niccolascassel/altosdofloresta/README.md

altosdofloresta
===============

Altos do Floresta allotment's projects
