niccolascassel/altosdofloresta/Documentation/Flowcharts/PlumbingPressureControl.pdf

# CONTROLE DE PRESSÃO DO SISTEMA

Controla o acionamento das bombas de acordo com a pressão do sistema. Esta função é chamada pela função Main.

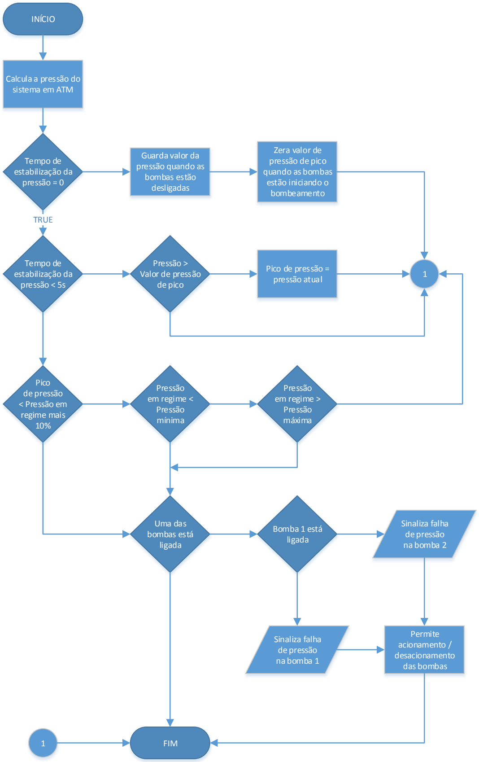
[picture p1: figure]
INÍCIO; Calcula a pressão do sistema em ATM; Tempo de estabilização da pressão = 0; Tempo de estabilização da pressão < 5s; TRUE; Guarda valor da pressão quando as bombas estão desligadas; Zera valor de pressão de pico quando as bombas estão iniciando o bombeamento; Pressão > Valor de pressão de pico; Pico de pressão = pressão atual; Pico de pressão < Pressão em regime mais 10%; Pressão em regime < Pressão mínima; Pressão em regime > Pressão máxima; Uma das bombas está ligada; Bomba 1 está ligada; Sinaliza falha de pressão na bomba 2; Sinaliza falha de pressão na bomba 1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
