niccolascassel/altosdofloresta/Documentation/Flowcharts/Signals.pdf

# Sinalizações

Aciona os LEDs de sinalização de acordo com as falhas que ocorrerem. Esta função é chamada pela função Main.

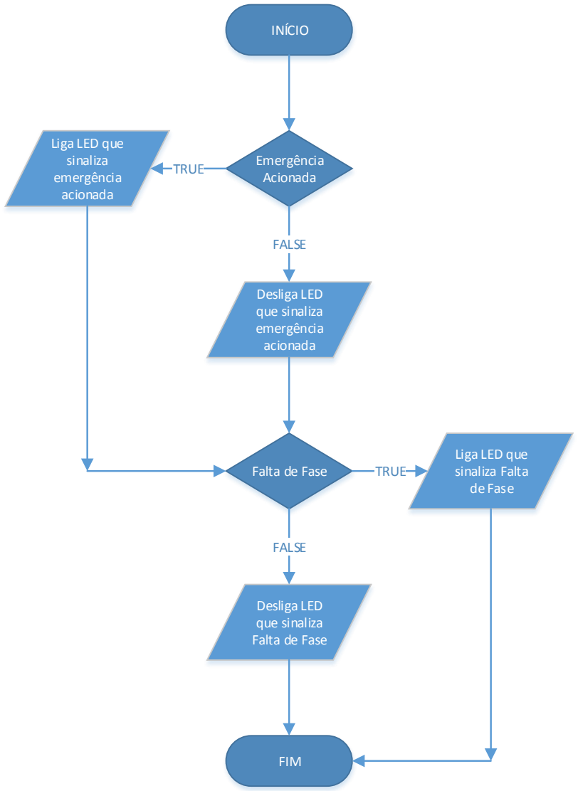
[picture p2: figure]
INÍCIO; Emergência Acionada; Liga LED que sinaliza emergência acionada; Desliga LED que sinaliza emergência acionada; Falta de Fase; Liga LED que sinaliza Falta de Fase; Desliga LED que sinaliza Falta de Fase; FIM; TRUE; FALSE
