niccolascassel/altosdofloresta/Documentation/ART-AltoFloresta.pdf

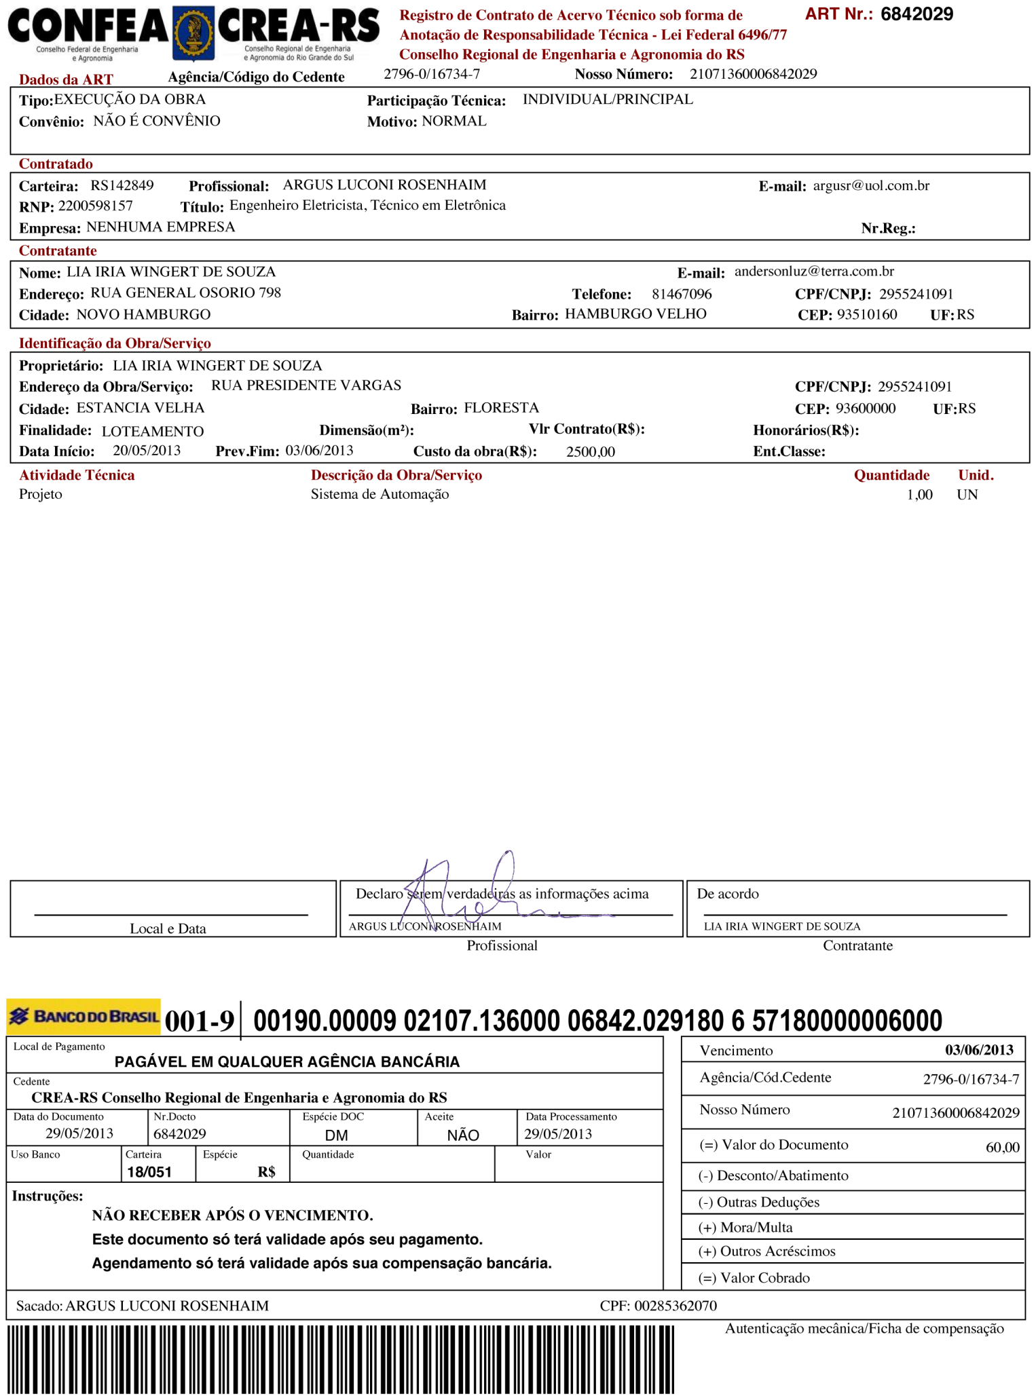
[picture p5: page 1]
