niccolascassel/altosdofloresta/Documentation/Flowcharts/Main.pdf

# MAIN

Esta função é chamada pela função de controle das bases de tempo.

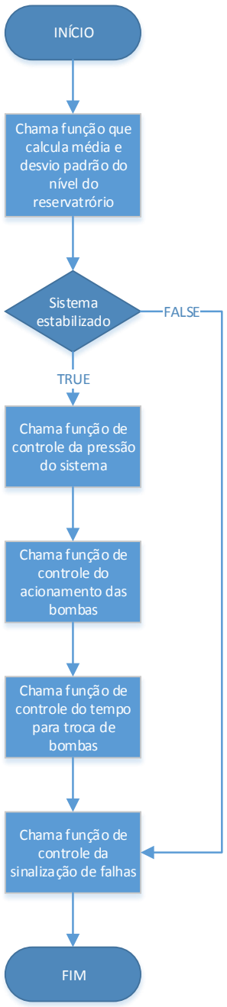
[picture p6: figure]
INÍCIO; Chama função que calcula média e desvio padrão do nível do reservatrório; Sistema estabilizado; Chama função de controle da pressão do sistema; Chama função de controle do acionamento das bombas; Chama função de controle do tempo para troca de bombas; Chama função de controle da sinalização de falhas; FIM; TRUE; FALSE
