niccolascassel/altosdofloresta/Documentation/Flowcharts/ReservoirLevelControl.pdf

# CONTROLE DO NÍVEL DO RESERVATÓRIO

Controla o acionamento das bombas de acordo com o nível do reservatório. Esta função é chamada pela função que calcula a média e o desvio padrão do nível do reservatório.

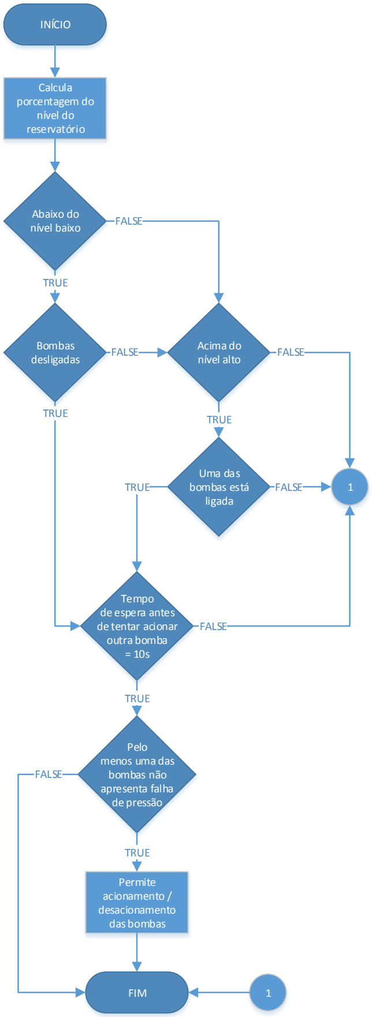
[picture p7: figure]
INÍCIO; Calcula porcentagem do nível do reservatório; Abaixo do nível baixo; Bombas desligadas; Acima do nível alto; Uma das bombas está ligada; Tempo de espera antes de tentar acionar outra bomba = 10s; Pelo menos uma das bombas não apresenta falha de pressão; Permite acionamento / desacionamento das bombas; FIM; FALSE; TRUE; TRUE TRUE
