niccolascassel/altosdofloresta/Documentation/Flowcharts/TimeDrivenPumpControl.pdf

# CONTROLE DE TEMPO DE BOMBA LIGADA

Controla o tempo que as bombas estão trabalhando para que trabalhem apenas 500 horas por vez.

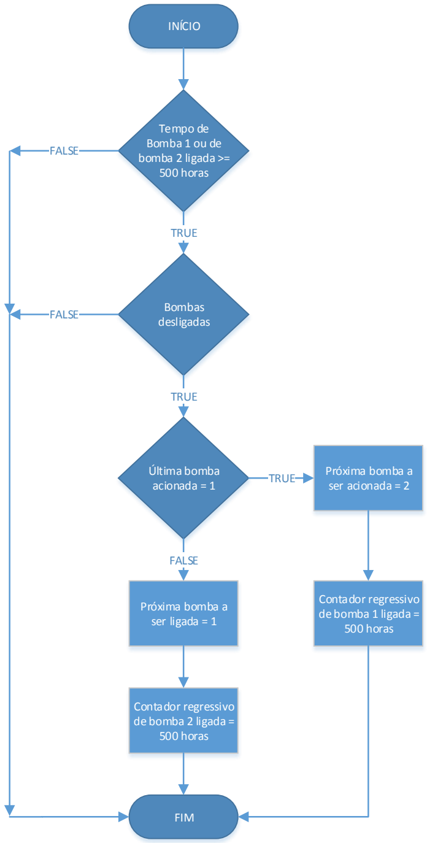
[picture p8: figure]
INÍCIO; Tempo de Bomba 1 ou de bomba 2 ligada >= 500 horas; Bombas desligadas; Última bomba acionada = 1; Próxima bomba a ser acionada = 2; Contador regressivo de bomba 1 ligada = 500 horas; Próxima bomba a ser ligada = 1; Contador regressivo de bomba 2 ligada = 500 horas; FIM; TRUE; FALSE
