niccolascassel/altosdofloresta/(list of files, cad)

Other CAD files:
Drawings/07 - SPDA Reservatório Superior.dwg
Drawings/06 - Instalação Sensor Nível e Quadro Reservatório.dwg
Drawings/05 - Layout QGBT e Quadro de Instrumentação.dwg
Drawings/03 - Esquema Elétrico do QGBT.dwg
Drawings/04 - Esquema Elétrico Instrumentação e Listas.dwg
Drawings/01 - Situação, Entrada e Aterramento.dwg
Drawings/02 - Casa de Bombas & Quadro de Cargas.dwg
Drawings/Calhas e Trilhos.dwg
Drawings/CAIXA_PASSAGEM_SAIDA.dwg
