niccolascassel/altosdofloresta/Documentation/Flowcharts/CommunicationChecks.pdf

# CHECAGEM DOS LINKS DE COMUNICAÇÃO

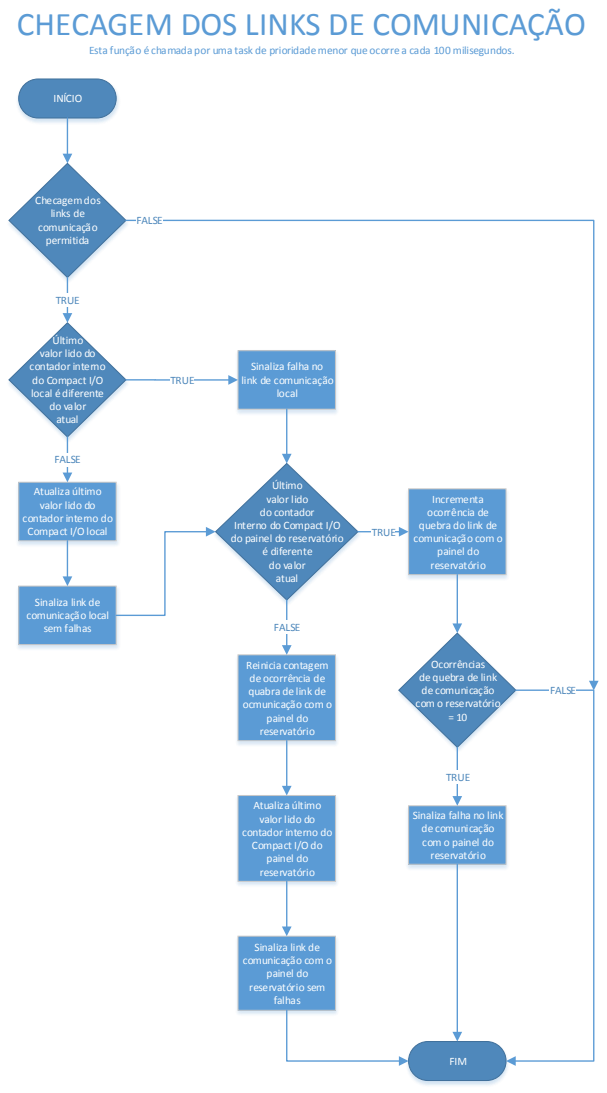
[picture p9: page 1]
INÍCIO; local; FIM; Checagem dos links de comunicação permitida; TRUE; FALSE

Esta função é chamada por uma task de prioridade menor que ocorre a cada 100 milisegundos.

Último
valor lido do
contador interno
do Compact I/O
local é diferente
do valor
atual

Sinaliza falha no
link de comunicação

valor lido
do contador
Interno do Compact I/O
do painel do reservatório
é diferente

Atualiza último
contador interno do
Compact I/O local

Incrementa
ocorrência de
quebra do link de
comunicação com o
painel do
reservatório

Sinaliza link de
comunicação local
sem falhas

Ocorrências
de quebra de link
de comunicação
com o reservatório

Reinicia contagem
de ocorrência de
quabra de link de
ocmunicação com o

Compact I/O do

Sinaliza falha no link
com o painel do

reservatório sem
falhas
