niccolascassel/altosdofloresta/Documentation/Flowcharts/DrivePumpControl.pdf

# CONTROLE DE ACIONAMENTO DAS BOMBAS

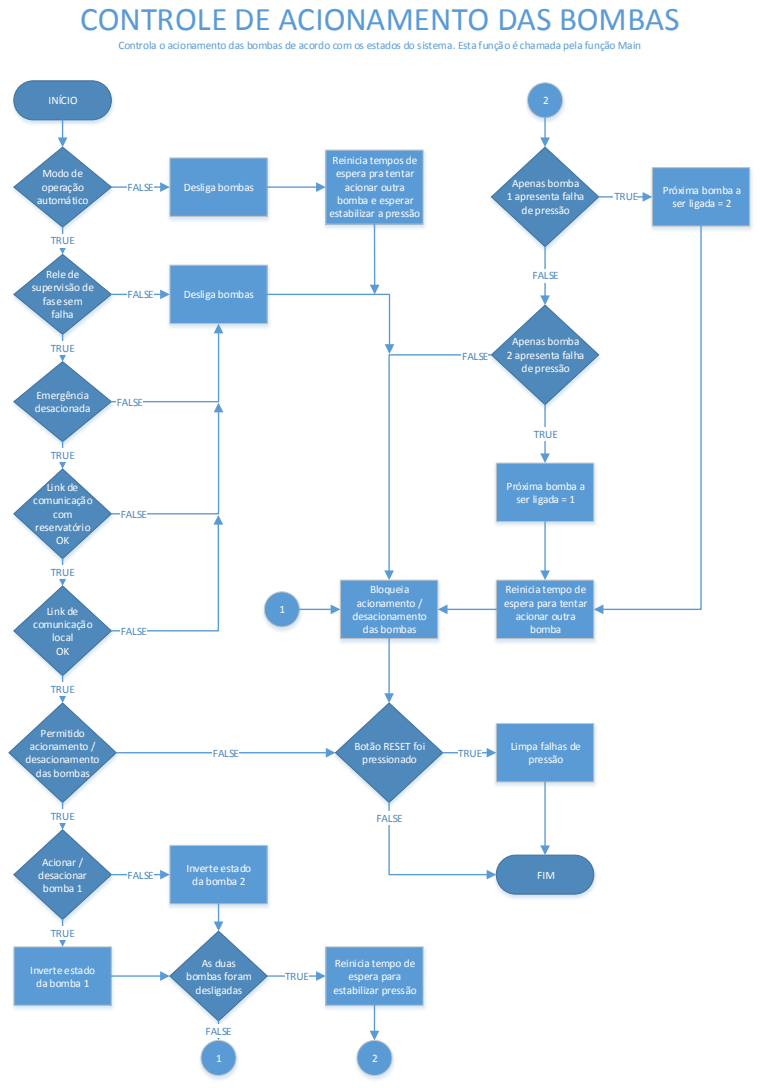
[picture p10: page 1]
INÍCIO; Modo de operação automático; Rele de supervisão de fase sem falha; Emergência desacionada; Link de comunicação com reservatório OK; Link de comunicação local OK; Permitido acionamento / desacionamento das bombas; Acionar / desacionar bomba 1; Inverte estado da bomba 1; Inverte estado da bomba 2; As duas bombas foram desligadas; Desliga bombas; FALSE; TRUE; Apenas bomba 1 apresenta falha de pressão; Apenas bomba 2 apresenta falha de pressão; Próxima bomba a ser ligada = 2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

Controla o acionamento das bombas de acordo com os estados do sistema. Esta função é chamada pela função Main

Reinicia tempos de
espera pra tentar
acionar outra
bomba e esperar
estabilizar a pressão

Reinicia tempo de
espera para tentar
bomba

Botão RESET foi
pressionado

Limpa falhas de
pressão

espera para
estabilizar pressão
