niccolascassel/altosdofloresta/Documentation/Flowcharts/StandardDeviation.pdf

# CÁLCULO DA MÉDIA E DESVIO PADRÃO

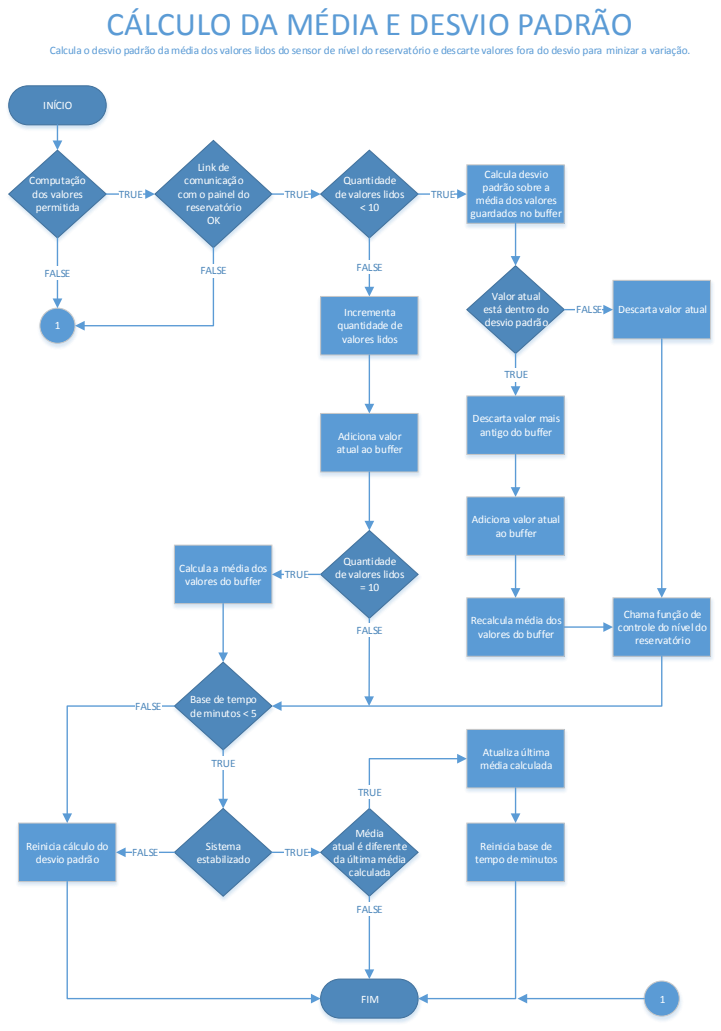
[picture p11: page 1]
INÍCIO; Computação dos valores permitida; Quantidade de valores lidos < 10; Incrementa quantidade de valores lidos; Quantidade de valores lidos = 10; TRUE; FALSE; Sistema estabilizado; Atualiza última média calculada; FIM

Calcula o desvio padrão da média dos valores lidos do sensor de nível do reservatório e descarte valores fora do desvio para minizar a variação.

Link de
comunicação
com o painel do
reservatório

Calcula desvio
padrão sobre a
média dos valores
guardados no buffer

Valor atual
está dentro do
desvio padrão

Descarta valor atual

Descarta valor mais
antigo do buffer

Adiciona valor
atual ao buffer

Adiciona valor atual
ao buffer

Calcula a média dos
valores do buffer

Recalcula média dos

Chama função de
controle do nível do

Base de tempo
de minutos < 5

Média
atual é diferente
da última média
calculada

Reinicia cálculo do

Reinicia base de
tempo de minutos
