niccolascassel/altosdofloresta/Documentation/Flowcharts/TimeBase.pdf

# CONTROLE DAS BASES DE TEMPO

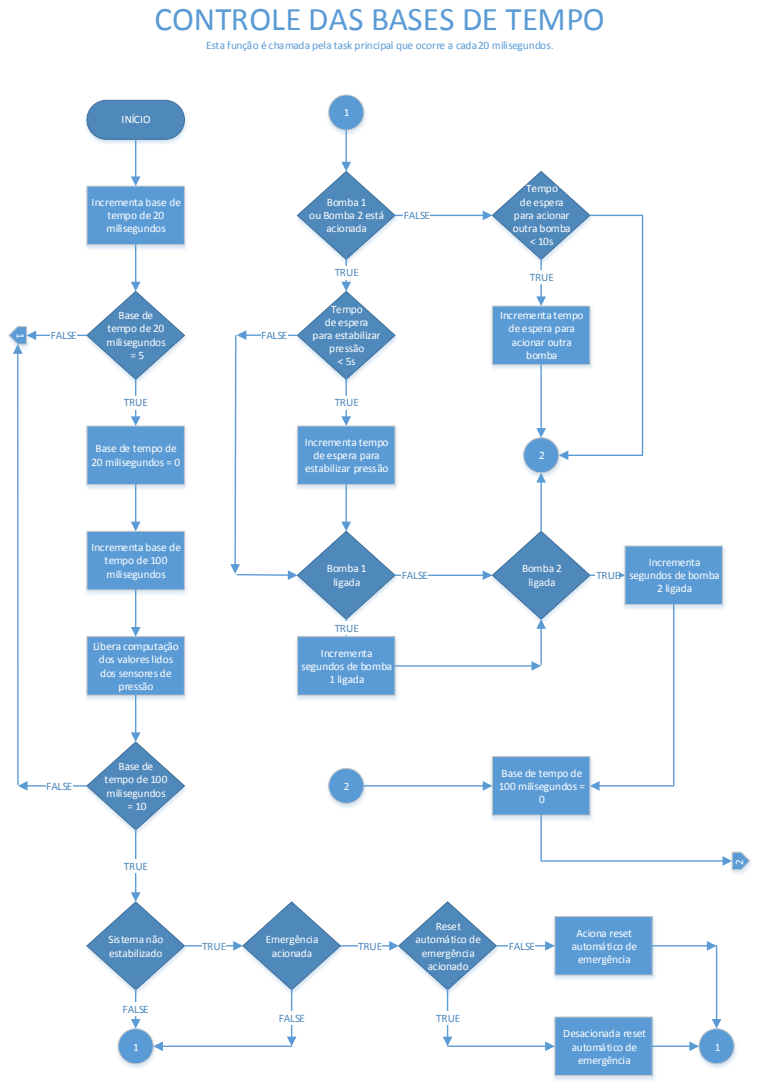
[picture p12: page 1]
INÍCIO; Base de tempo de 20 milisegundos = 5; Base de tempo de 100 milisegundos = 10; Sistema não estabilizado; Emergência acionada; Reset automático de emergência acionado; Aciona reset automático de emergência; Desacionada reset automático de emergência; TRUE; FALSE; Tempo de espera para estabilizar pressão < 5s; Tempo de espera para acionar outra bomba < 10s; Bomba 1 ligada; Bomba 2 ligada

Esta função é chamada pela task principal que ocorre a cada 20 milisegundos.

Incrementa base de
tempo de 20
milisegundos

Bomba 1
ou Bomba 2 está
acionada

Incrementa tempo
de espera para
acionar outra
bomba

Base de tempo de
20 milisegundos = 0

estabilizar pressão

tempo de 100

Incrementa
segundos de bomba
2 ligada

Libera computação
dos valores lidos
dos sensores de
pressão

1 ligada

100 milisegundos =

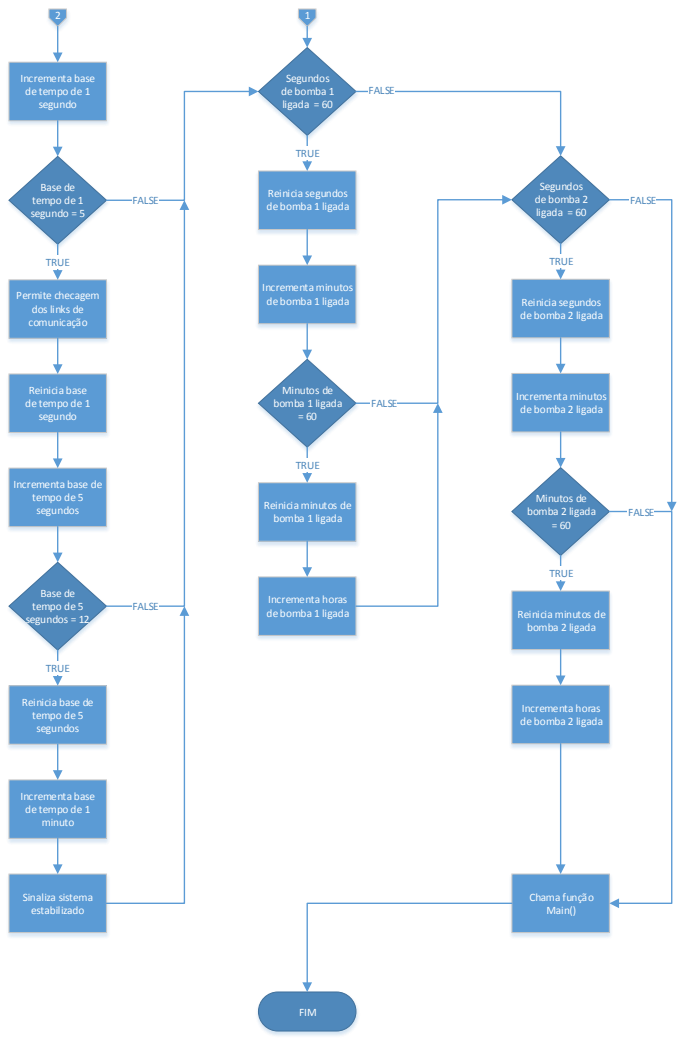
[picture p13: page 2]
Base de tempo de 1 segundo = 5; Base de tempo de 5 segundos = 12; Sinaliza sistema estabilizado; TRUE; Segundos de bomba 1 ligada = 60; Minutos de bomba 1 ligada = 60; Segundos de bomba 2 ligada = 60; Minutos de bomba 2 ligada = 60; FALSE; Chama função Main(); FIM

Incrementa base
de tempo de 1
segundo

Reinicia segundos
de bomba 1 ligada

Incrementa minutos

Permite checagem
dos links de
comunicação

de bomba 2 ligada

Reinicia base

Incrementa base de
tempo de 5
segundos

Reinicia minutos de
bomba 1 ligada

Incrementa horas

bomba 2 ligada

Reinicia base de

minuto
