niccolascassel/altosdofloresta/(commit log)

2014-12-17 Drawings - Added approved as As Built drawings
    [01 - Situação, Entrada e Aterramento.dwg, 02 - Casa de Bombas & Quadro de Cargas.dwg, 03 - Esquema Elétrico do QGBT.dwg, 04 - Esquema Elétrico Instrumentação e Listas.dwg, 05 - Layout QGBT e Quadro de Instrumentação.dwg, 06 - Instalação Sensor Nível e Quadro Reservatório.dwg, 07 - SPDA Reservatório Superior.dwg, CAIXA_PASSAGEM_SAIDA.dwg]
2015-02-02 Drawings - Drawing 03 - Added multimeter and fixed the manual drive
    [03 - Esquema Elétrico do QGBT.dwg]
2015-02-03 Updated drawings to follow what has been mounted
    [01 - Situação, Entrada e Aterramento.dwg, 02 - Casa de Bombas & Quadro de Cargas.dwg, 03 - Esquema Elétrico do QGBT.dwg, 04 - Esquema Elétrico Instrumentação e Listas.dwg, 05 - Layout QGBT e Quadro de Instrumentação.dwg, 06 - Instalação Sensor Nível e Quadro Reservatório.dwg, 07 - SPDA Reservatório Superior.dwg]
2015-04-21 Sources - PLC - Added reset of emergency relay when the system is starting
2015-04-21 Sources - PLC - Added slave modbus device on Serial Line 1 and addressed variables to be read by this modbus device
2015-07-03 Drawings - AS BUILT - Fixed drawings to follow the execution
    [01 - Situação, Entrada e Aterramento.dwg, 02 - Casa de Bombas & Quadro de Cargas.dwg, 03 - Esquema Elétrico do QGBT.dwg, 04 - Esquema Elétrico Instrumentação e Listas.dwg, 05 - Layout QGBT e Quadro de Instrumentação.dwg, 06 - Instalação Sensor Nível e Quadro Reservatório.dwg, 07 - SPDA Reservatório Superior.dwg]
2015-07-05 Drawings - AS BUILT - Added the flowchart of CLP code
